aybguhyb/RM2024_ORIGIN_EG_CTRLER/README.md

# 作者

###### 起源Origin

@aybGuhyb(B站同名)

@王宇涵

如有疑问或建议，欢迎联系

# 演示视频

https://www.bilibili.com/video/BV14HgfeFEut/

~~欢迎投币~~

# 声明

1. 本开源仅限于Robomaster参赛队之间队内交流使用，不允许任何商业用途。
2. 开源目的为加强参赛队之间交流，提高自身和其他参赛队的水平。
3. 本开源的最终解释权为华东理工大学起源Origin战队所有。

# 其他

代码很屎，但是能用
