aybguhyb/RM2024_ORIGIN_EG_CTRLER/机械结构/自定义控制器.SLDASM

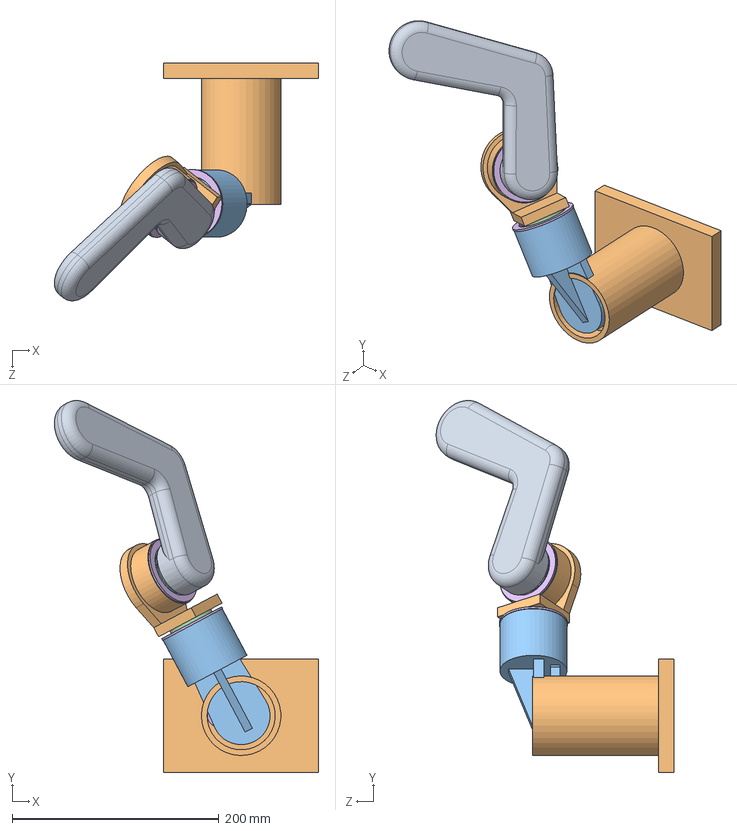
[picture p5: CAD file, 2024-06-25]
机械结构/自定义控制器.SLDASM
255.9 x 360.3 x 230.2 mm
基座
电位器 x 3
28x52x12轴承 x 3
轴承内套1 x 3
轴承外套1 x 3
电位器旋钮套 x 3
轴承内套2 x 3
大臂
PITCH
握把
