aybguhyb/RM2024_ORIGIN_EG_CTRLER/机械结构/核心部件.SLDASM

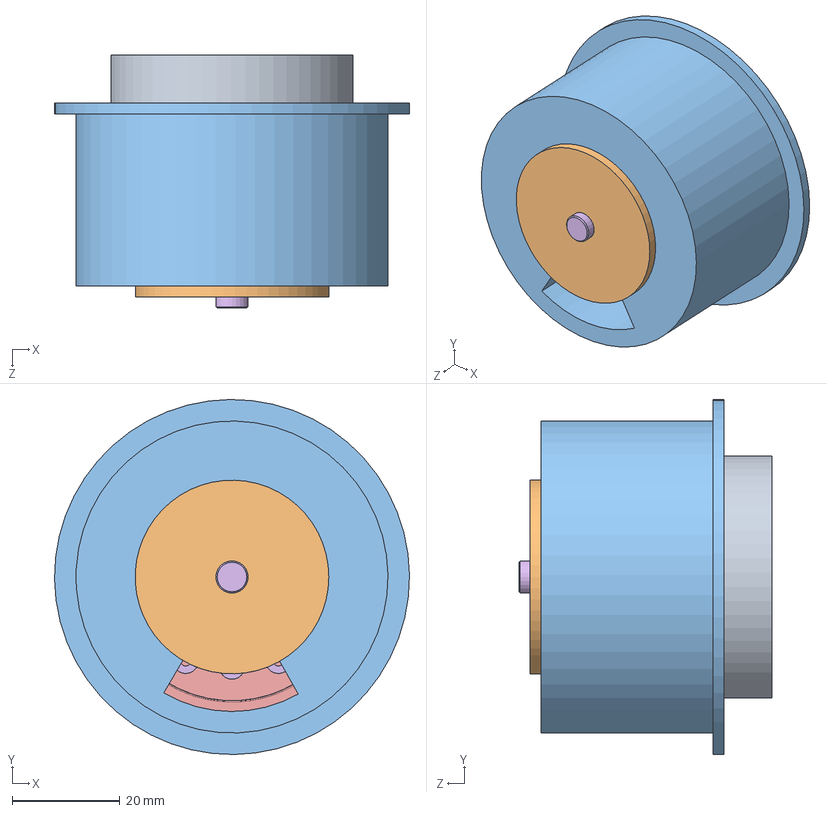
[picture p6: CAD file, 2024-06-25]
机械结构/核心部件.SLDASM
66.0 x 66.0 x 47.1 mm
电位器
28x52x12轴承
轴承内套1
轴承外套1
电位器旋钮套
轴承内套2
