aybguhyb/RM2024_ORIGIN_EG_CTRLER/机械结构/装配体2.SLDASM

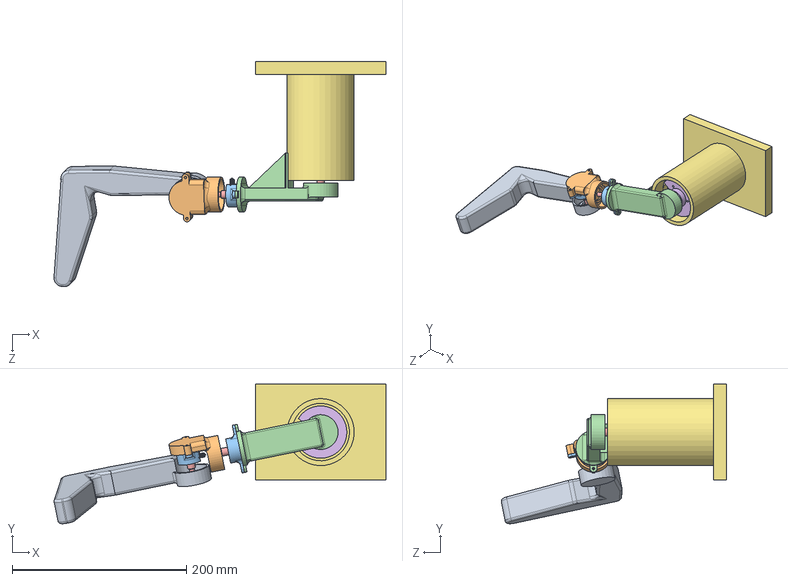
[picture p7: CAD file, 2024-06-25]
机械结构/装配体2.SLDASM
381.3 x 160.3 x 258.9 mm
基座
新外套1
电位器 x 3
yaw盖子
新外套2 x 2
pitch盖子
手柄
