aybguhyb/RM2024_ORIGIN_EG_CTRLER/机械结构/新外套.STEP

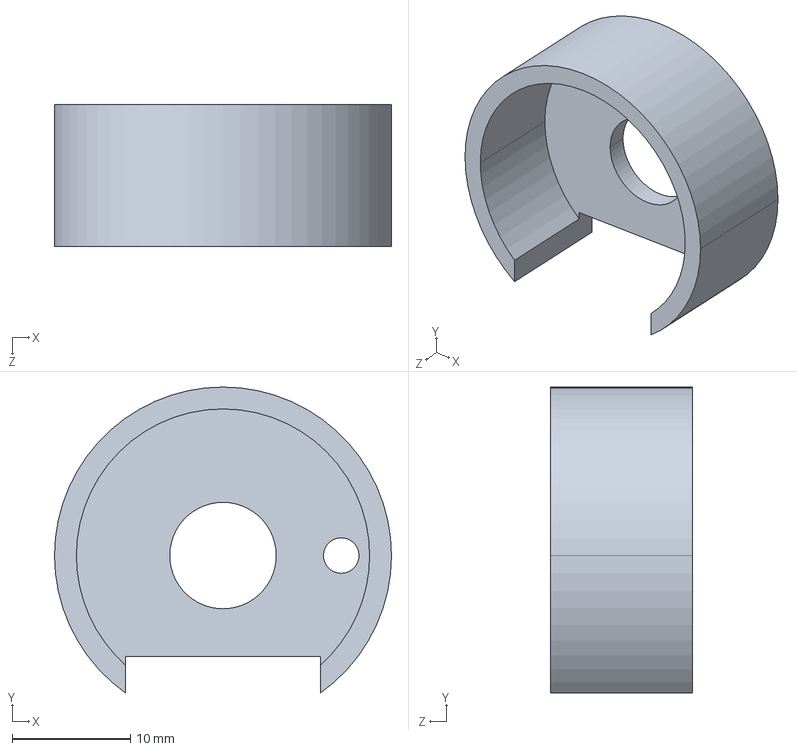
[picture p8: CAD file, 2024-06-25]
机械结构/新外套.STEP
28.5 x 25.9 x 12.0 mm
