aybguhyb/RM2024_ORIGIN_EG_CTRLER/机械结构/大臂.SLDPRT

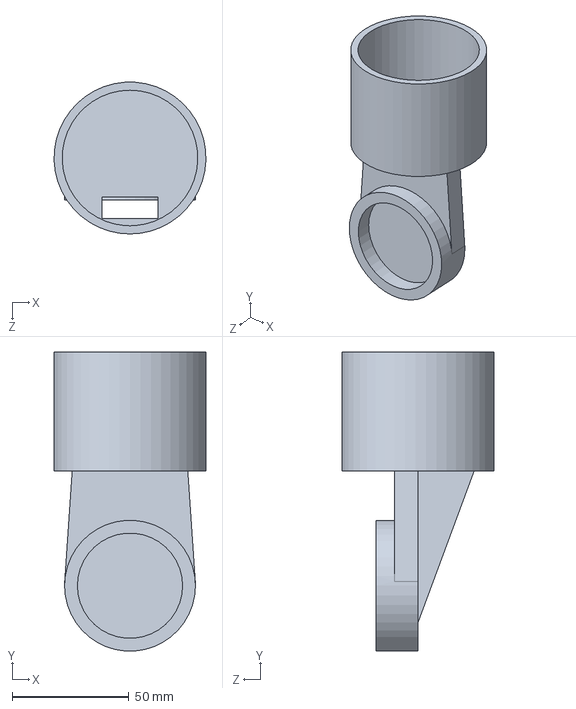
[picture p9: CAD file, 2024-06-25]
机械结构/大臂.SLDPRT
65.0 x 127.9 x 65.0 mm
