aybguhyb/RM2024_ORIGIN_EG_CTRLER/机械结构/yaw盖子.SLDPRT

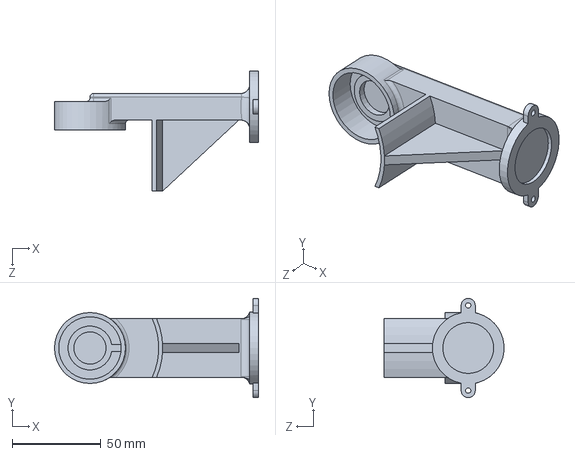
[picture p10: CAD file, 2024-06-25]
机械结构/yaw盖子.SLDPRT
115.0 x 56.0 x 67.7 mm
