aybguhyb/RM2024_ORIGIN_EG_CTRLER/机械结构/PITCH.SLDPRT

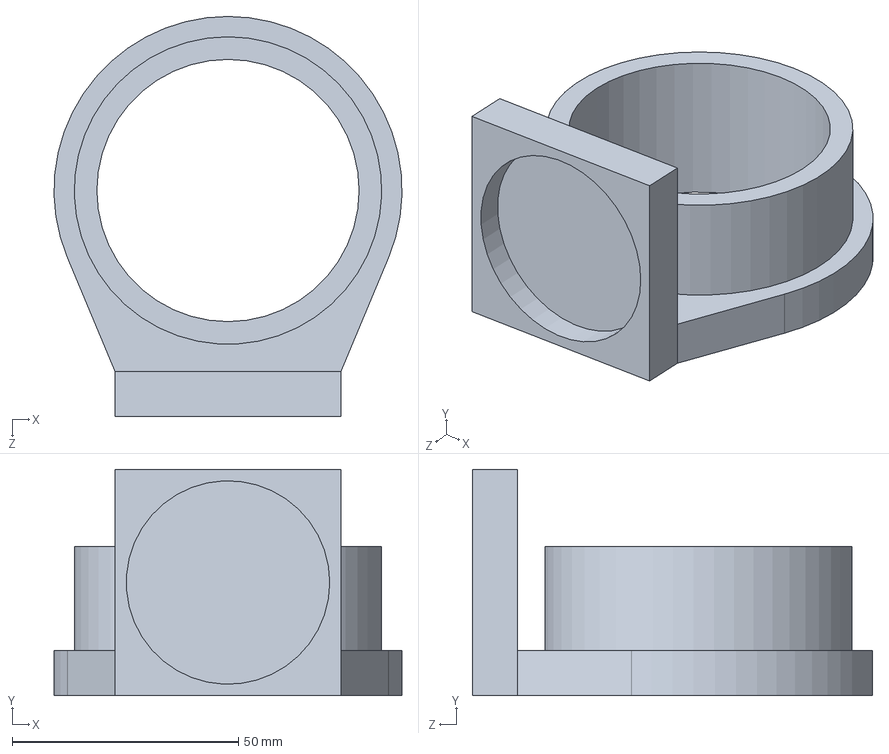
[picture p11: CAD file, 2024-06-25]
机械结构/PITCH.SLDPRT
77.0 x 50.0 x 88.5 mm
