aybguhyb/RM2024_ORIGIN_EG_CTRLER/机械结构/电位器旋钮套.SLDPRT

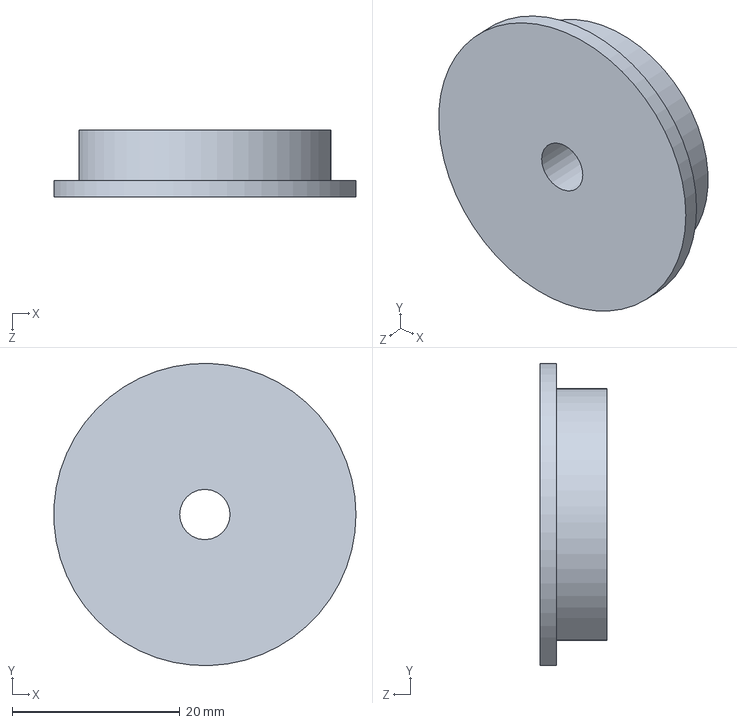
[picture p12: CAD file, 2024-06-25]
机械结构/电位器旋钮套.SLDPRT
36.0 x 36.0 x 8.00 mm
