aybguhyb/RM2024_ORIGIN_EG_CTRLER/机械结构/设备仓.SLDPRT

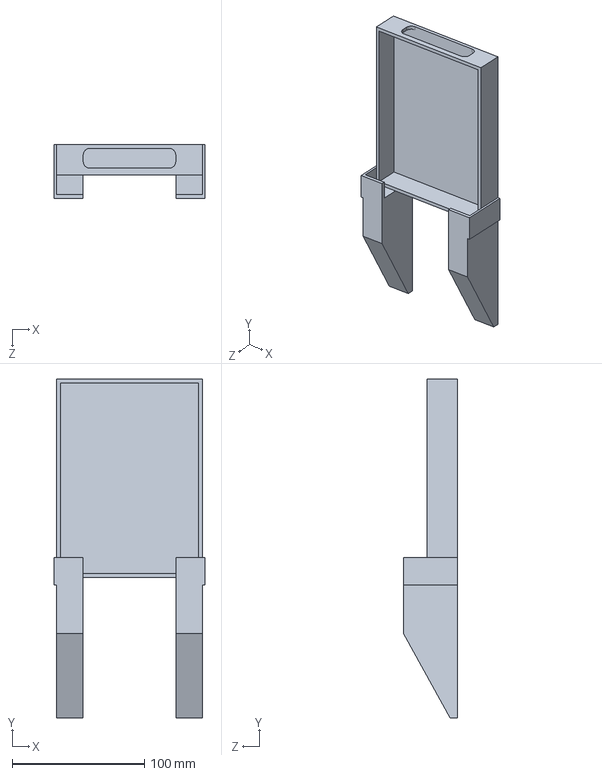
[picture p13: CAD file, 2024-06-25]
机械结构/设备仓.SLDPRT
114.0 x 256.2 x 41.0 mm
