aybguhyb/RM2024_ORIGIN_EG_CTRLER/机械结构/yaw下端固定环.SLDPRT

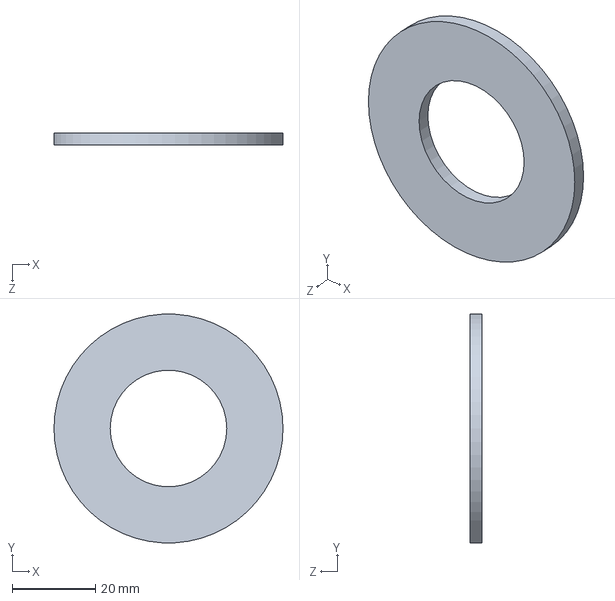
[picture p14: CAD file, 2024-06-25]
机械结构/yaw下端固定环.SLDPRT
55.0 x 54.9 x 3.00 mm
