aybguhyb/RM2024_ORIGIN_EG_CTRLER/机械结构/3x6x2.5.SLDPRT

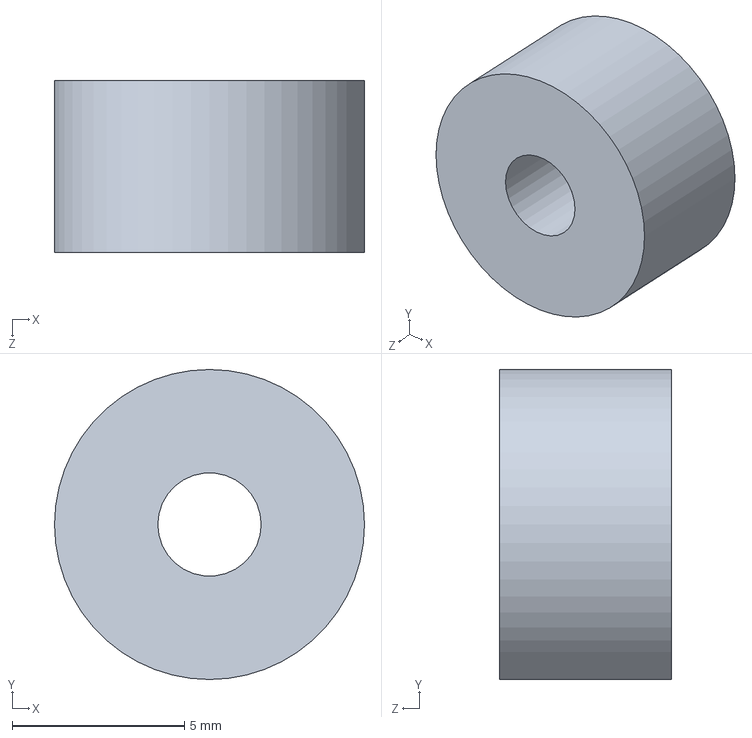
[picture p15: CAD file, 2024-06-25]
机械结构/3x6x2.5.SLDPRT
9.00 x 9.00 x 5.00 mm
