aybguhyb/RM2024_ORIGIN_EG_CTRLER/机械结构/轴承内套1.SLDPRT

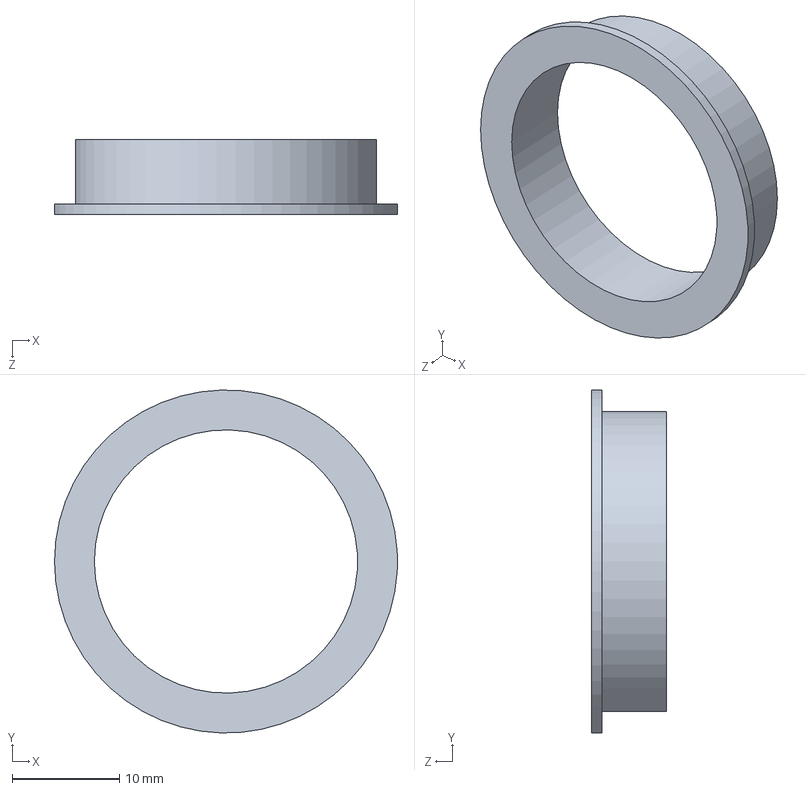
[picture p16: CAD file, 2024-06-25]
机械结构/轴承内套1.SLDPRT
31.9 x 31.9 x 7.00 mm
