aybguhyb/RM2024_ORIGIN_EG_CTRLER/机械结构/新外套2.SLDPRT

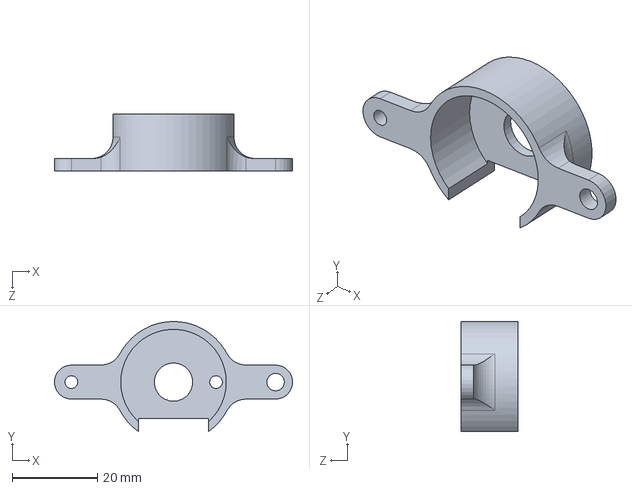
[picture p17: CAD file, 2024-06-25]
机械结构/新外套2.SLDPRT
55.9 x 25.9 x 13.5 mm
