aybguhyb/RM2024_ORIGIN_EG_CTRLER/机械结构/基座.SLDPRT

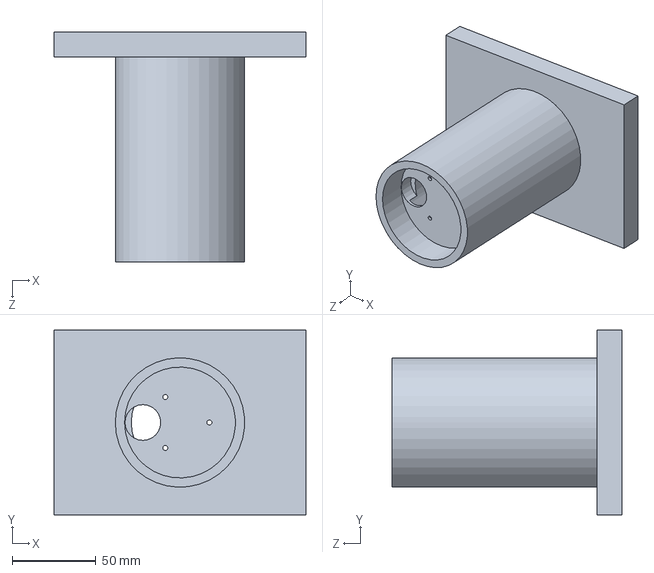
[picture p18: CAD file, 2024-06-25]
机械结构/基座.SLDPRT
150.0 x 110.0 x 137.0 mm
