aybguhyb/RM2024_ORIGIN_EG_CTRLER/机械结构/新外套1.SLDPRT

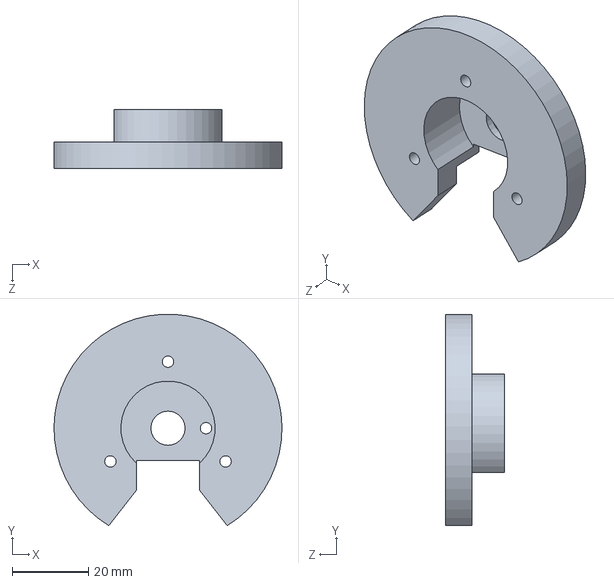
[picture p19: CAD file, 2024-06-25]
机械结构/新外套1.SLDPRT
60.0 x 55.6 x 15.5 mm
