aybguhyb/RM2024_ORIGIN_EG_CTRLER/机械结构/电位器.SLDPRT

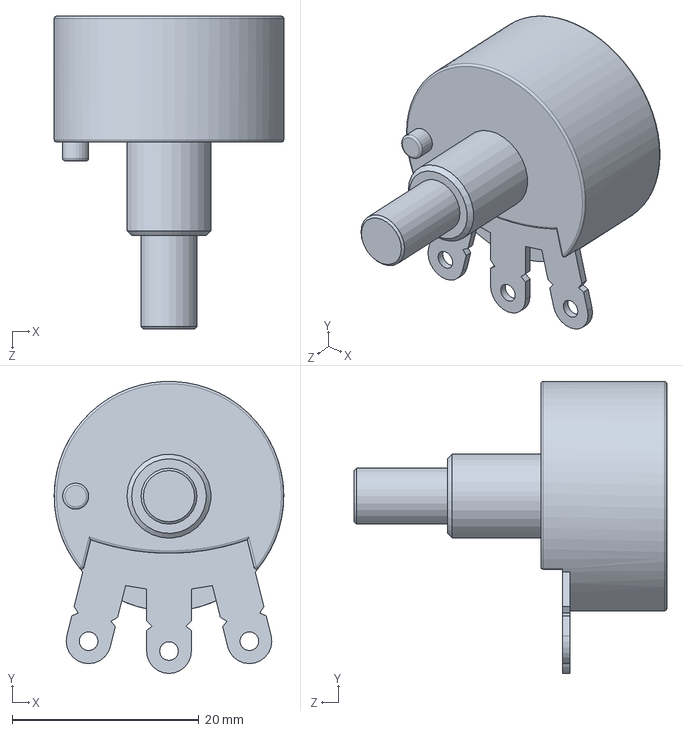
[picture p20: CAD file, 2024-06-25]
机械结构/电位器.SLDPRT
24.6 x 31.3 x 33.5 mm
