aybguhyb/RM2024_ORIGIN_EG_CTRLER/机械结构/零件3.STEP

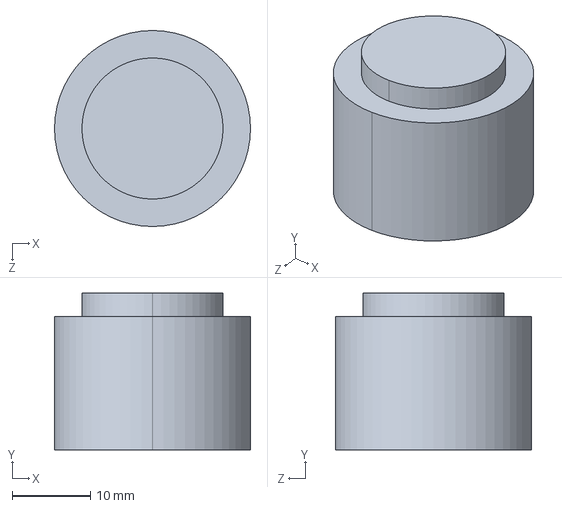
[picture p21: CAD file, 2024-06-25]
机械结构/零件3.STEP
25.0 x 20.0 x 25.0 mm
