aybguhyb/RM2024_ORIGIN_EG_CTRLER/机械结构/轴承外套1.SLDPRT

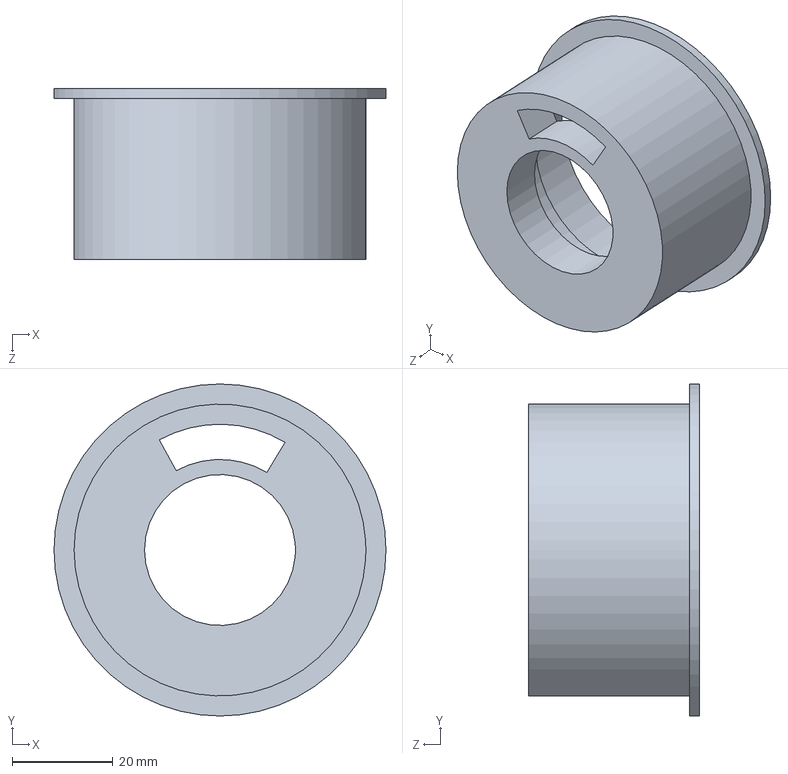
[picture p22: CAD file, 2024-06-25]
机械结构/轴承外套1.SLDPRT
66.0 x 66.0 x 34.0 mm
