aybguhyb/RM2024_ORIGIN_EG_CTRLER/机械结构/握把.SLDPRT

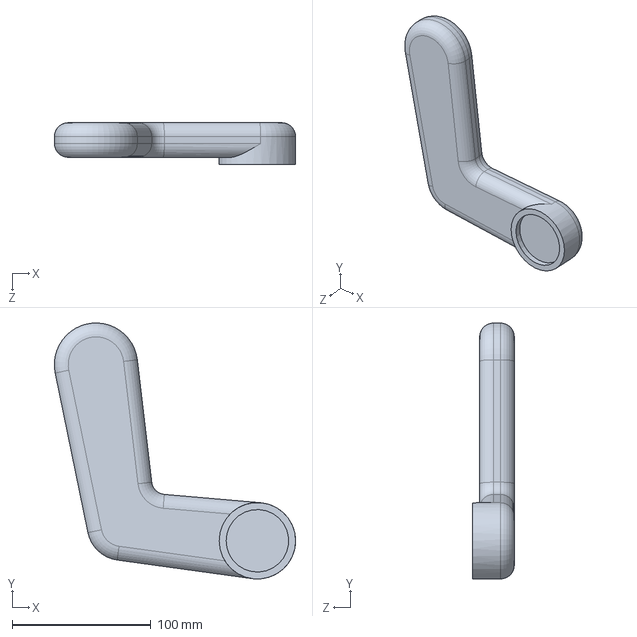
[picture p23: CAD file, 2024-06-25]
机械结构/握把.SLDPRT
173.6 x 184.2 x 30.0 mm
