aybguhyb/RM2024_ORIGIN_EG_CTRLER/机械结构/轴承内套2.SLDPRT

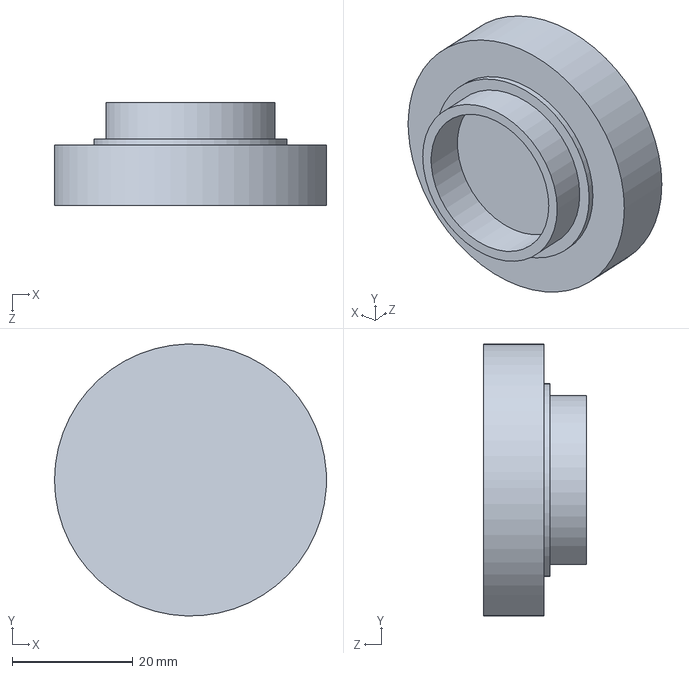
[picture p24: CAD file, 2024-06-25]
机械结构/轴承内套2.SLDPRT
45.0 x 45.0 x 17.0 mm
