aybguhyb/RM2024_ORIGIN_EG_CTRLER/机械结构/pitch盖子.SLDPRT

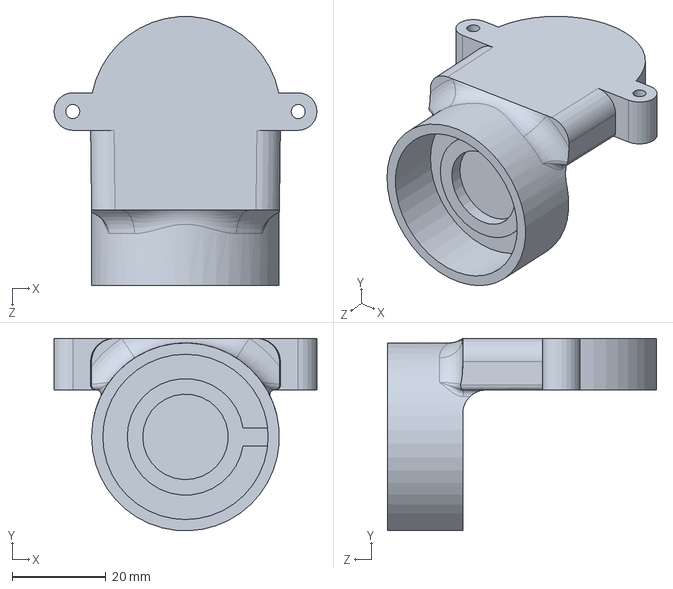
[picture p25: CAD file, 2024-06-25]
机械结构/pitch盖子.SLDPRT
56.0 x 41.0 x 57.2 mm
