aybguhyb/RM2024_ORIGIN_EG_CTRLER/机械结构/28x52x12轴承.SLDPRT

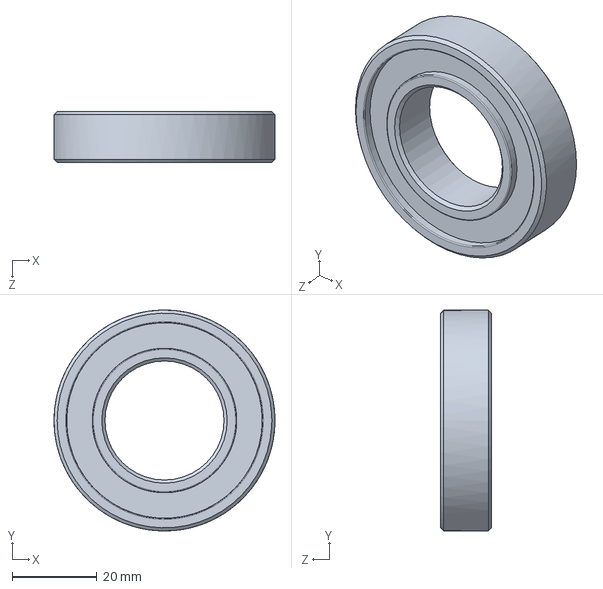
[picture p26: CAD file, 2024-06-25]
机械结构/28x52x12轴承.SLDPRT
52.0 x 52.0 x 12.0 mm
