aybguhyb/RM2024_ORIGIN_EG_CTRLER/机械结构/手柄.SLDPRT

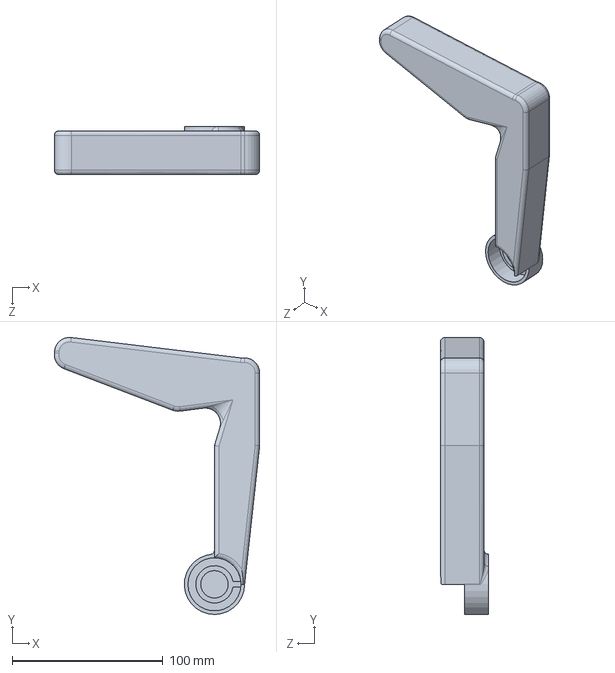
[picture p27: CAD file, 2024-06-25]
机械结构/手柄.SLDPRT
136.1 x 183.5 x 32.0 mm
