aybguhyb/RM2024_ORIGIN_EG_CTRLER/机械结构/装配体1.SLDASM

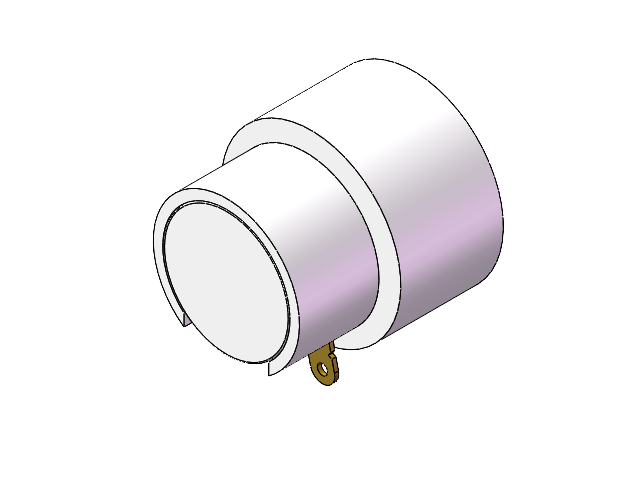
[picture p28: CAD file, 2024-06-25]
机械结构/装配体1.SLDASM
新外套
电位器
零件3
