aybguhyb/RM2024_ORIGIN_EG_CTRLER/(list of files, cad)

Other CAD files:
机械结构/新外套.SLDPRT
机械结构/零件3.SLDPRT
